21f3003256/Smart-Traffic-Light-Controller/docs/images/Project_Setup.png

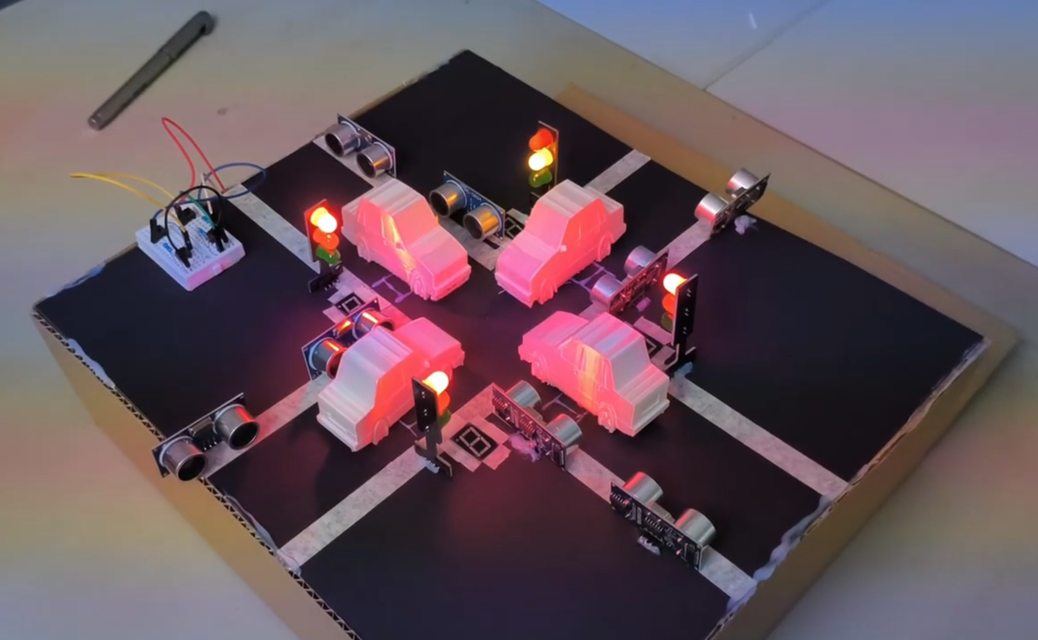
docs/images/Project_Setup.png
