21f3003256/Smart-Traffic-Light-Controller/hardware_details/NUCLEO_F446RE_Board_Pic.jpg

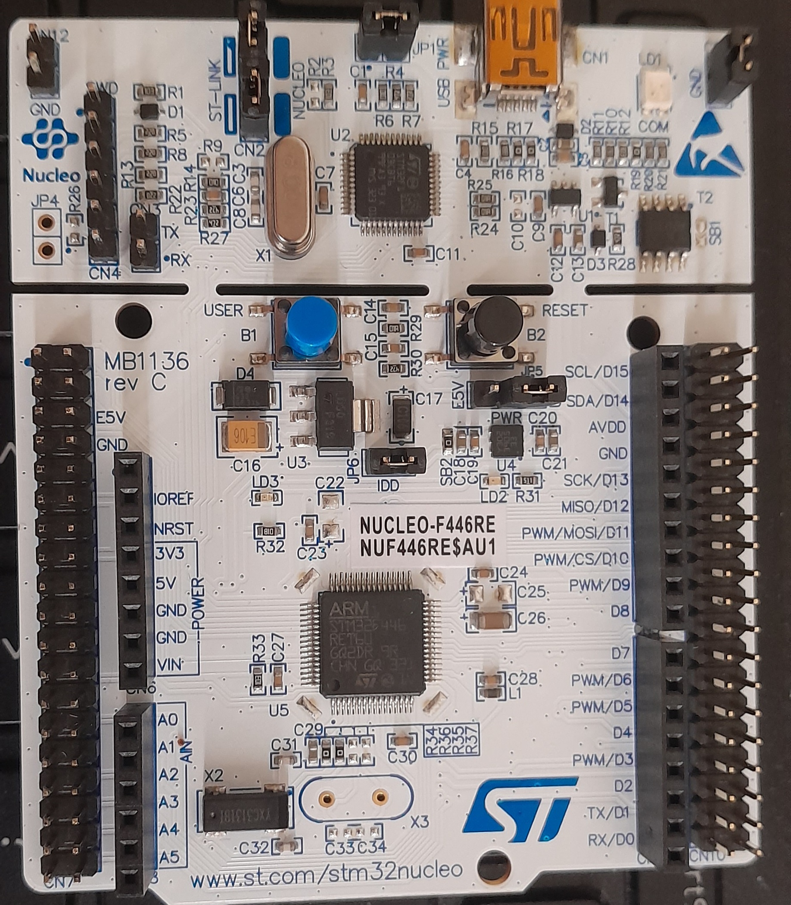
hardware_details/NUCLEO_F446RE_Board_Pic.jpg
