21f3003256/Smart-Traffic-Light-Controller/README.md

Smart Adaptive traffic light system for a four-way junction is implemented that can dynamically adjust the green light duration at each intersection based on real-time traffic flow using the STM32 Cortex-M4 microcontroller (NUCLEO-F446RE Board).

REPORT and VIDEO can be viewed at: 
https://github.com/21f3003256/Smart-Traffic-Light-Controller/tree/main/milestones/<milestone_num>

Project Demonstration has been given at https://www.youtube.com/watch?v=iuQci4bm_ME&t=2s

#Team Members: 
Jiong Sin 
Chun Yee
Dev Verma
