21f3003256/Smart-Traffic-Light-Controller/hardware_details/STM32_Hardware_Connections_Details.docx

## Pin Connections 1. HC‑SR04 Ultrasonic Sensors

- Pins on STM32:
  - Shared TRIG → PB0 (Arduino A3, CN8)
  - ECHO Near/Far per direction:
    - N: PB7 (near), PC12 (far)
    - E: PB12 (near), PB13 (far)
    - S: PB14 (near), PB15 (far)
    - W: PA11 (near), PA12 (far)
- Terminals: VCC, GND, TRIG, ECHO
- Working: TRIG sends a short pulse; sensor emits ultrasonic burst. ECHO returns a pulse width proportional to distance. If distance < threshold (≈3 cm), lane is considered occupied. Used for vehicle detection.

## 🔹 2. Pedestrian Push Buttons

- Pins on STM32:
  - N: PA0 (EXTI0)
  - E: PA1 (EXTI1)
  - S: PA4 (EXTI4)
  - W: PB8 (EXTI9_5)
- Terminals: Two leads (switch + ground). Wired between GPIO and +3.3 V.
- Working: Active‑HIGH tactile switches. Internal pulldown keeps pin low until pressed. On press, EXTI interrupt triggers pedestrian request handling.

## 🔹 3. LED Traffic Light Modules

- Pins on STM32:
  - N: PA7 (Red), PA6 (Yellow), PA5 (Green)
  - E: PB6 (Red), PC7 (Yellow), PA9 (Green)
  - S: PA8 (Red), PB10 (Yellow), PB4 (Green)
  - W: PB5 (Red), PB3 (Yellow), PA10 (Green)
- Terminals: 3 pins per module (R/Y/G).
- Working: GPIO drives LEDs directly. Red = stop, Green = go, Yellow = transition. Adaptive timing (2s, 5s, 10s) based on sensor occupancy.

## 🔹 4. 7‑Segment LED Displays (Common Cathode)

- Pins on STM32:
  - Segments a–g: PC0, PC1, PC2, PC3, PC4, PC5, PC6
  - Digit selects: PC8 (N), PC9 (E), PC10 (S), PC11 (W)
- Terminals: 7 segment pins + 1 cathode per digit.
- Working: Multiplexed display. Shared segment bus lights segments; digit select enables one display at a time. Shows countdown or traffic state. Needs resistors (330 Ω per segment).
