21f3003256/Smart-Traffic-Light-Controller/milestones/milestone_1/Blinky_App_STM32_G3_Report.docx

Setting up Blinky LED on STM32 NUCLEO-F446RE

First we have the board ready with us - NUCLEO-F446RE

Then we installed the following softwares:

i) STM32CubeMX Version: 6.17.0

https://www.st.com/content/st_com/en/stm32cubemx.html#st-get-software

ii) STM32CubeIDE

Version: 2.1.0

Build: 27993_20260219_1630 (UTC)

https://www.st.com/en/development-tools/stm32cubeide.html

After installing both, The we opened the STM32CubeMX application

1. File->New Project
2. Under Board Selector, need to type “NUCLEO-F446RE” and click on Start Project and then click on yes to Initialize all the peripherals to default value.
3. Make sure to check that 39/50 GPIOs pin unselected and under Project Manager tab, choose STM32CubeIDE instead of EWARM.
4. Ctrl+S-> Save the project location and then click on “Generate Code”
5. IOC File will be generated
6. Open STM32CubeIDE application and then import STM32CubeMX project
7. Select the parent directory where ioc file is present and then the project with all the files will get available on the left hand side.
8. Go to Core->Src->main.c file
9. Inside main.c file search for while(1) loop where user has to write the code.
10. Enter the desired code for blinking the LEd at LD2 pin with 1 second interval.

HAL_GPIO_TogglePin(GPIOA, GPIO_PIN_5);

HAL_Delay(1000);

11. Go to Project->Clean and then Build
12. Connect the Hardware and make sure the lights are ON.
13. Go to Help->ST-LINK Upgrade and then click on “Open in Update Mode” and then click on Upgrade.
14. After the Upgrade successful message comes, click on the Run->Run As->STM32 C/C++ Application
15. The LED will blink red and gree present at the top of the board making sure that the flashing is taking place.
16. Once flashing is done, then automatically the LED on LD2 blinks ta 1 second interval.
