21f3003256/Smart-Traffic-Light-Controller/(commit log)

2026-05-19 Update .gitignore for STM32CubeIDE
    Added entries to ignore STM32CubeIDE folders, settings, temporary logs, and OS-generated files.
2026-05-20 Add STM32CubeMX base project structure and LED blink code
2026-05-20 Added the Blinky LED App installation and basic code writing steps
2026-05-21 NUCLEO F446RE Board pic
    The pic of NUCLEO STM32 F446R6 Board where our project working is going.
2026-05-21 STM32 NUCLEO64 Board Manual (Hardware & Pinlayout)
2026-06-11 Fixed the sensor issue and synchronized 7-seg display with traffic light
    [main.c]
2026-06-29 main.c file modified by Chun Yee, addition of sensor pinlist and related datasheets, Presentation slides being uploaded
